Emute-Lab-Instruments/uSEQ-expansion-analogue_outputs/README.md

# uSEQ-expansion-analogue_outputs
8 channel analogue output expansion board
