Emute-Lab-Instruments/uSEQ-expansion-analogue_outputs/version_0.1a/Print Schematic.pdf

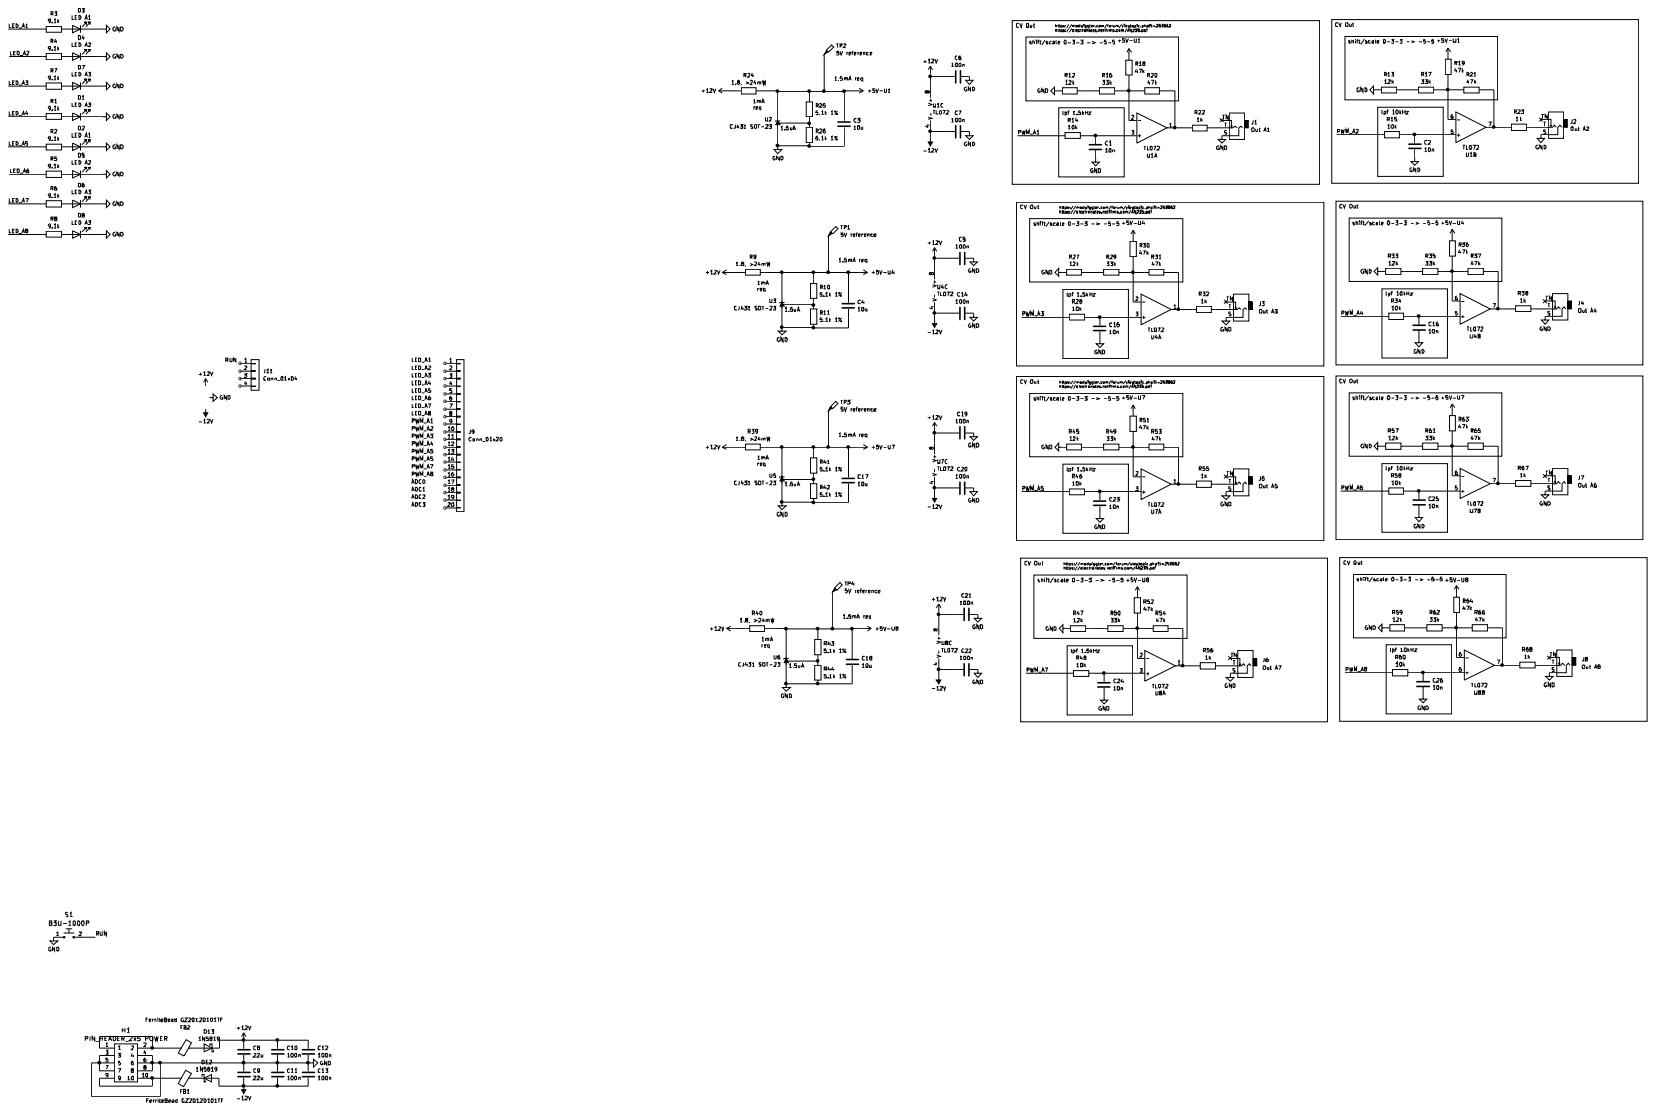
[picture p1: page 1]
