Emute-Lab-Instruments/uSEQ-expansion-analogue_outputs/(commit log)

2024-07-03 2024-07-03 save point
    two output channels test layout.
    [uSeqAnalogOuts.kicad_pcb, uSeqAnalogOuts.kicad_sch]
2024-07-04 2ch routing test
    with 2 channels and leds routed
    [uSeqAnalogOuts.kicad_pcb]
2024-07-04 Added version 0.1a
    0.1a uses hierachical schematic and replicate layout plugin to copy a pair of channels 4 times
    [2_chan_pwm_dac.kicad_sch, uSeqAnalogOuts_01a.kicad_pcb, uSeqAnalogOuts_01a.kicad_sch, uSeqAnalogOuts_01b.kicad_pcb]
2024-07-05 v0.1a - all but ground plane
    All routed but needs planes adding
    [RP2040-GPIO-Functions.xlsx, uSeqAnalogOuts_01a.kicad_pcb, uSeqAnalogOuts_01a.kicad_sch, uSeqAnalogOuts_01b.kicad_pcb]
2024-07-08 Ground plane complete
    [uSeqAnalogOuts_01a.kicad_pcb]
2024-07-08 Final check 2
    [RP2040-GPIO-Functions.xlsx, uSeqAnalogOuts_01a.kicad_pcb]
2024-07-09 Freed up ADC0 for use
    [RP2040-GPIO-Functions.xlsx, uSeqAnalogOuts_01a.kicad_pcb, uSeqAnalogOuts_01a.kicad_sch]
2024-07-11 rerouted to free up all adc inputs for use.
    [RP2040-GPIO-Functions.xlsx, uSeqAnalogOuts_01a.kicad_pcb, uSeqAnalogOuts_01a.kicad_sch]
2024-09-25 hole correction
    increased hole sizes
    LEDs - 3.2 mm
    Jack Sockets 6.2
2024-11-13 i2c by define
    fixed i2c bus setup by board define
    expander - fixed animation
